HartnettMatt/AdvancedEmbeddedSoftware/README.md

# AdvancedEmbeddedSoftware
Matt's work in ECEN5713, Advanced Embedded Software
