HartnettMatt/AdvancedEmbeddedSoftware/final-project/hardware/3D_Printing/HBridge Mount.FCStd

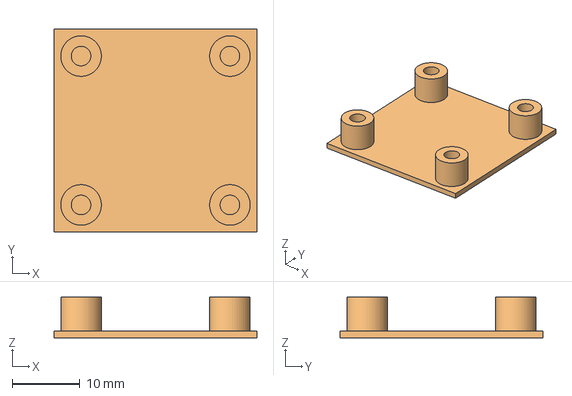
[picture p2: CAD file, 2025-11-16]
final-project/hardware/3D_Printing/HBridge Mount.FCStd
30.0 x 30.0 x 6.00 mm
H Bridge Mount001
H Bridge Mount
