HartnettMatt/AdvancedEmbeddedSoftware/final-project/hardware/3D_Printing/BottomPlatform.FCStd

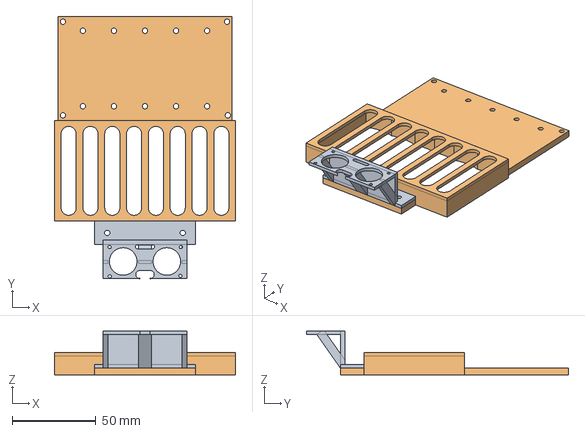
[picture p3: CAD file, 2025-11-16]
final-project/hardware/3D_Printing/BottomPlatform.FCStd
108.0 x 156.2 x 26.0 mm
Sensor Platform
Bottom Platform
