HartnettMatt/AdvancedEmbeddedSoftware/final-project/hardware/3D_Printing/9VBatteryHolder.FCStd

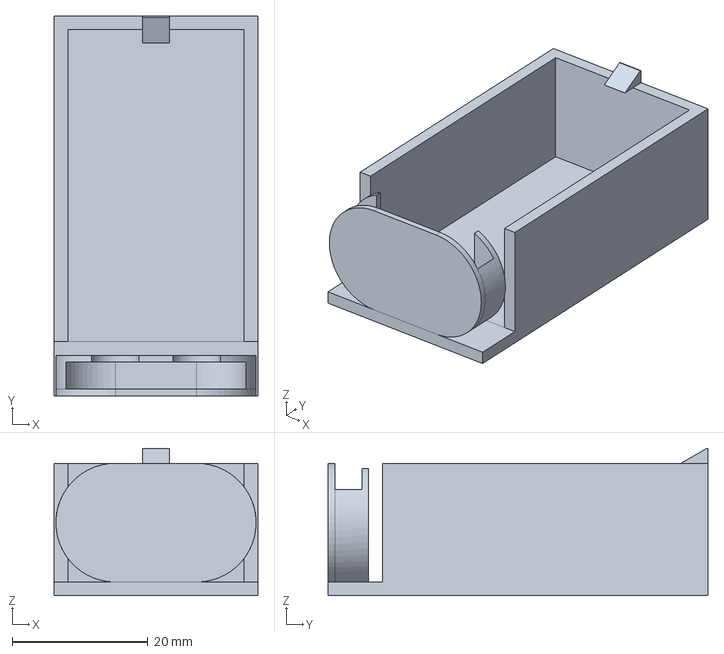
[picture p4: CAD file, 2025-11-16]
final-project/hardware/3D_Printing/9VBatteryHolder.FCStd
30.0 x 56.0 x 21.7 mm
