HartnettMatt/AdvancedEmbeddedSoftware/final-project/hardware/3D_Printing/PrimaryPlatform_v3.stl

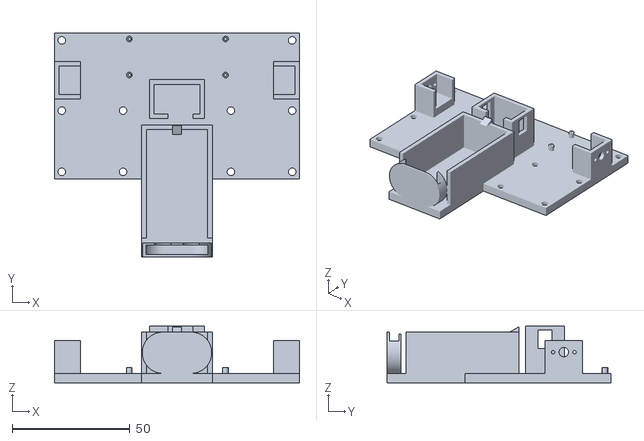
[picture p5: CAD file, 2025-11-16]
final-project/hardware/3D_Printing/PrimaryPlatform_v3.stl
104.0 x 95.0 x 24.0
