HartnettMatt/AdvancedEmbeddedSoftware/final-project/hardware/3D_Printing/WheelAdapter_v11.stl

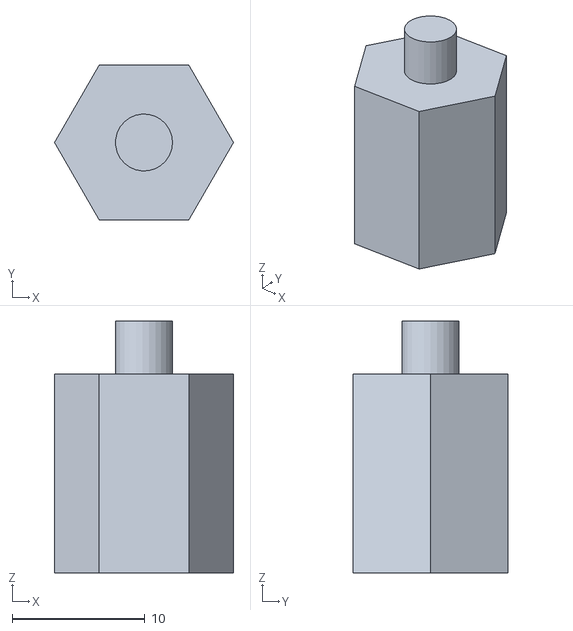
[picture p6: CAD file, 2025-11-16]
final-project/hardware/3D_Printing/WheelAdapter_v11.stl
13.5 x 11.7 x 19.0
