HartnettMatt/AdvancedEmbeddedSoftware/final-project/hardware/3D_Printing/Motor Platform.FCStd

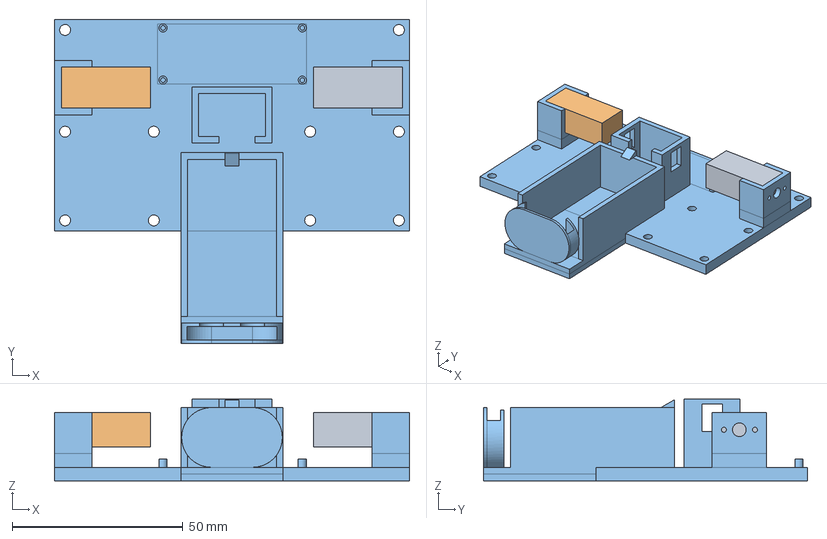
[picture p7: CAD file, 2025-11-16]
final-project/hardware/3D_Printing/Motor Platform.FCStd
104.0 x 95.0 x 24.0 mm
Motor001
Motor002
Primary Platform
