HartnettMatt/AdvancedEmbeddedSoftware/final-project/hardware/3D_Printing/Motor Mount.FCStd

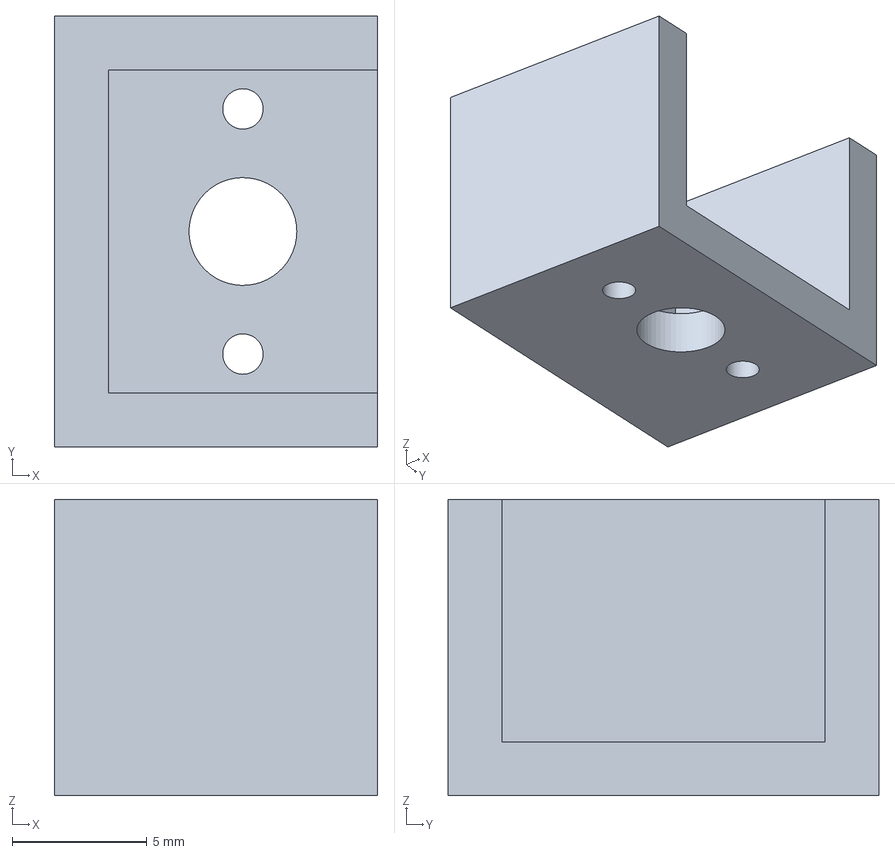
[picture p8: CAD file, 2025-11-16]
final-project/hardware/3D_Printing/Motor Mount.FCStd
12.0 x 16.0 x 11.0 mm
