HartnettMatt/AdvancedEmbeddedSoftware/final-project/hardware/3D_Printing/9VBatteryHolder_v3.stl

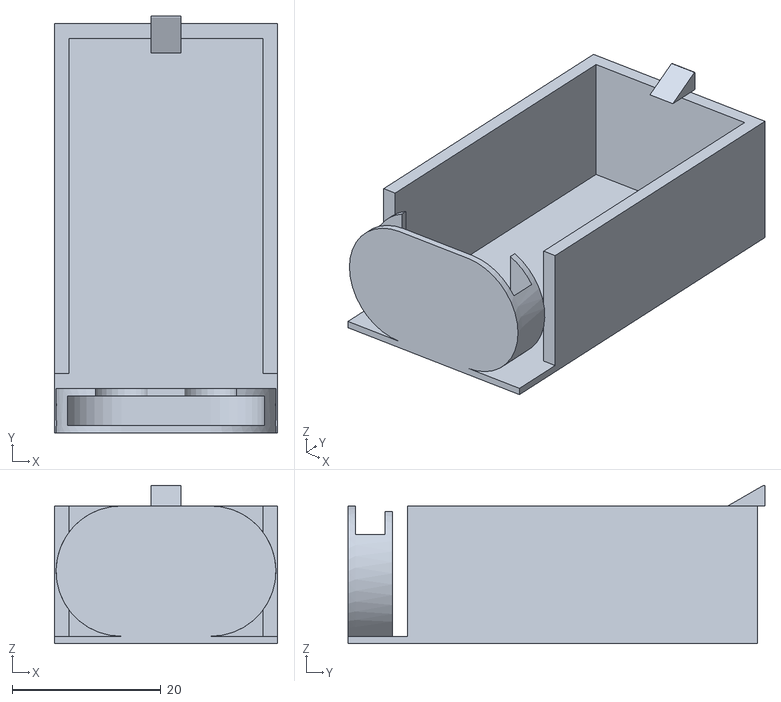
[picture p9: CAD file, 2025-05-31]
final-project/hardware/3D_Printing/9VBatteryHolder_v3.stl
30.0 x 56.0 x 21.3
