HartnettMatt/AdvancedEmbeddedSoftware/final-project/hardware/3D_Printing/MotorMount_v3.stl

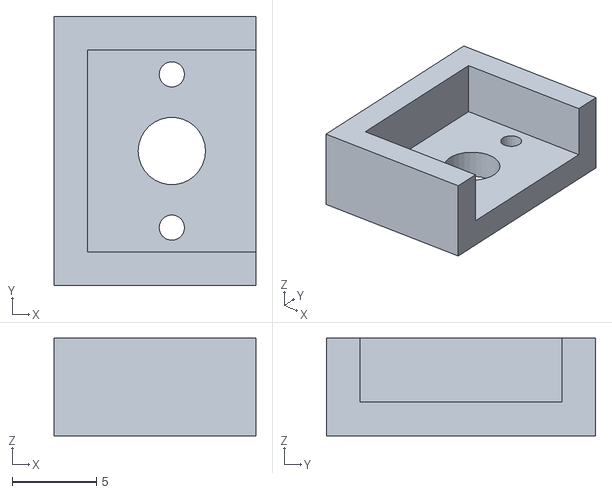
[picture p10: CAD file, 2025-05-31]
final-project/hardware/3D_Printing/MotorMount_v3.stl
12.0 x 16.0 x 5.80
