HartnettMatt/AdvancedEmbeddedSoftware/final-project/hardware/3D_Printing/Bottom Platform_v3.stl

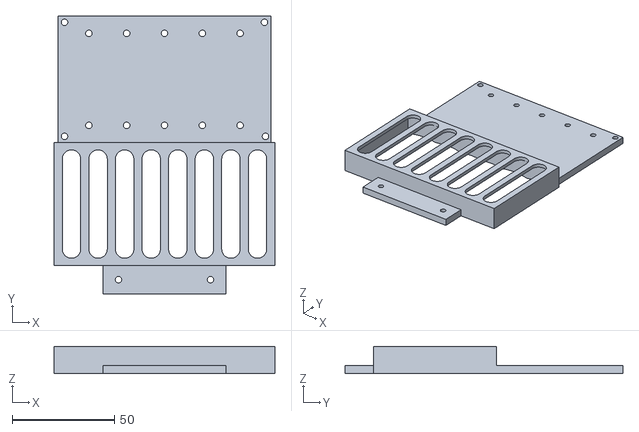
[picture p11: CAD file, 2025-05-31]
final-project/hardware/3D_Printing/Bottom Platform_v3.stl
108.0 x 136.0 x 13.3
