HartnettMatt/AdvancedEmbeddedSoftware/final-project/hardware/3D_Printing/Raspberry Pi Platform.FCStd

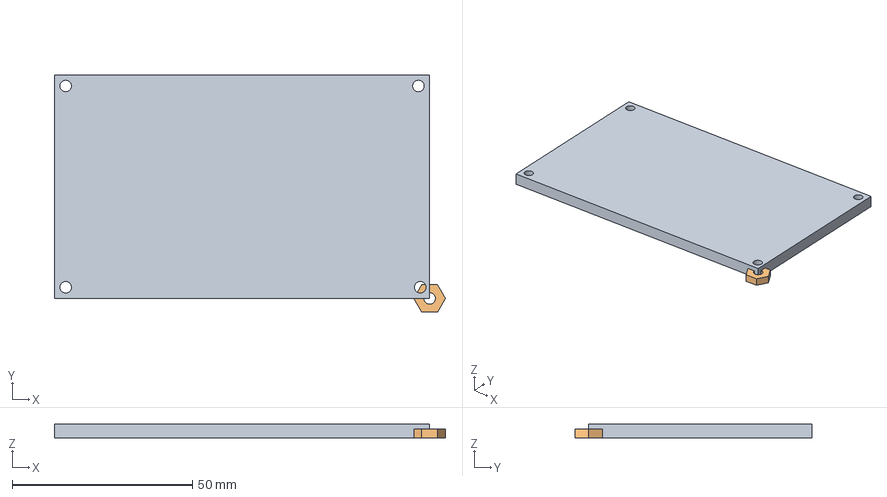
[picture p12: CAD file, 2025-05-23]
final-project/hardware/3D_Printing/Raspberry Pi Platform.FCStd
108.4 x 65.8 x 4.00 mm
Standard Platform
