HartnettMatt/AdvancedEmbeddedSoftware/final-project/hardware/3D_Printing/BottomPlatform-Sensor Platform.stl

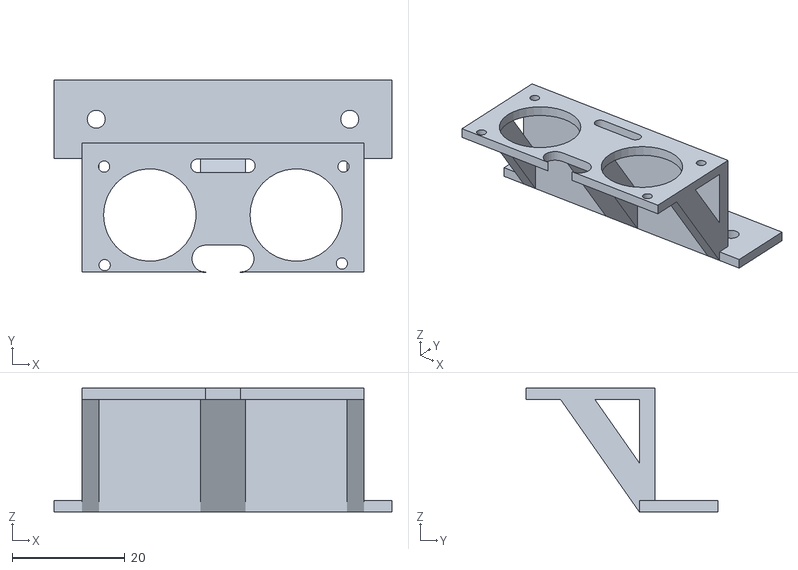
[picture p14: CAD file, 2025-05-23]
final-project/hardware/3D_Printing/BottomPlatform-Sensor Platform.stl
60.0 x 34.2 x 22.0
