HartnettMatt/AdvancedEmbeddedSoftware/final-project/hardware/3D_Printing/HCSR04_v1.stl

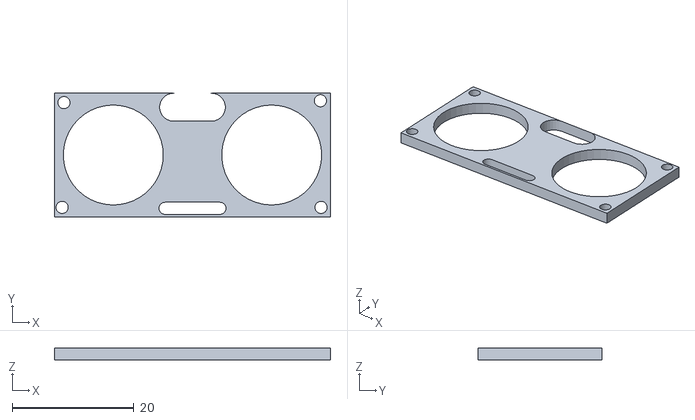
[picture p15: CAD file, 2025-04-28]
final-project/hardware/3D_Printing/HCSR04_v1.stl
45.3 x 20.3 x 2.00
