HartnettMatt/AdvancedEmbeddedSoftware/final-project/hardware/3D_Printing/EraserHolder_v1.stl

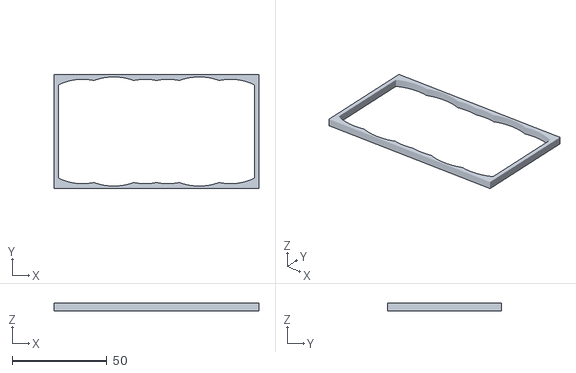
[picture p16: CAD file, 2025-04-25]
final-project/hardware/3D_Printing/EraserHolder_v1.stl
108.0 x 60.0 x 4.00
