HartnettMatt/AdvancedEmbeddedSoftware/final-project/hardware/3D_Printing/SwitchHolder_v3.stl

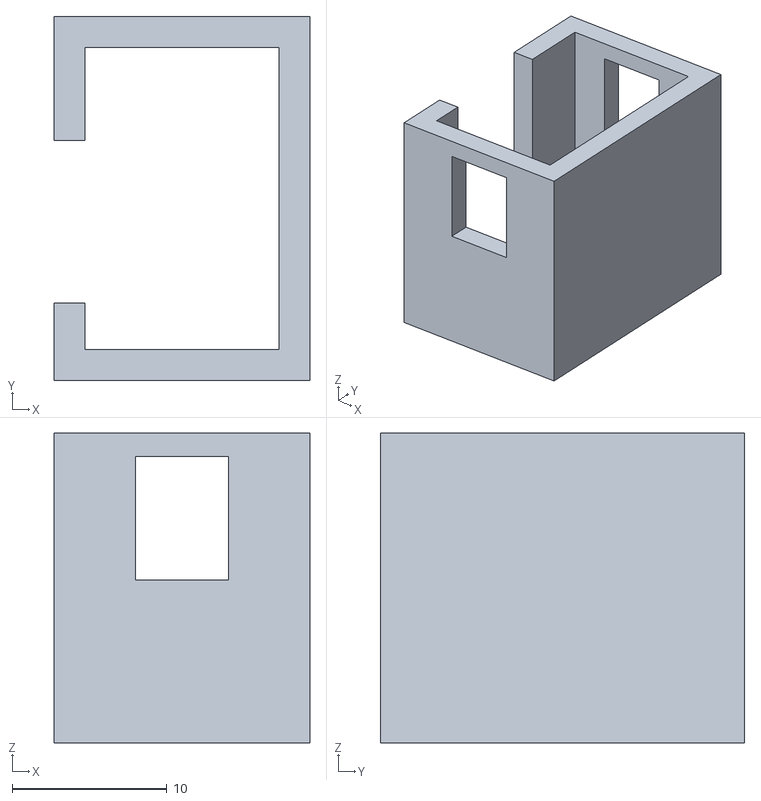
[picture p17: CAD file, 2025-04-19]
final-project/hardware/3D_Printing/SwitchHolder_v3.stl
16.5 x 23.5 x 20.0
