HartnettMatt/AdvancedEmbeddedSoftware/final-project/hardware/3D_Printing/BatteryPlatform_v1.stl

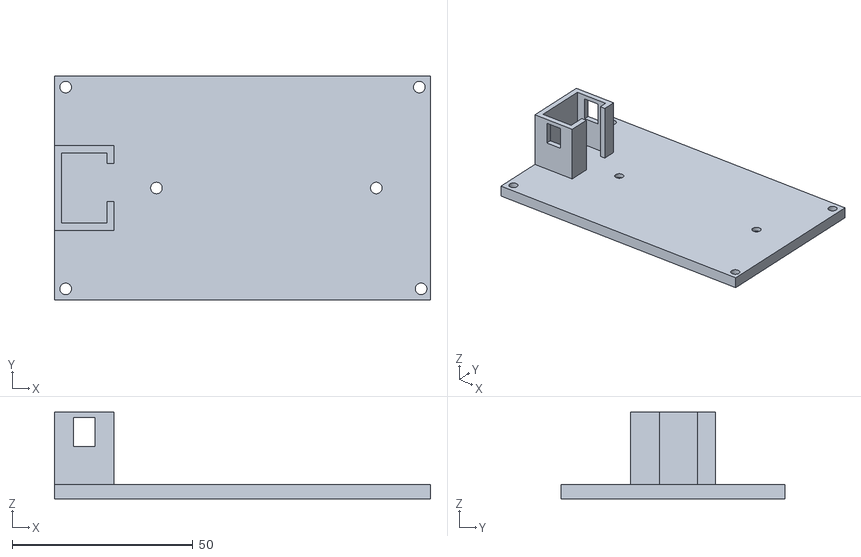
[picture p18: CAD file, 2025-04-19]
final-project/hardware/3D_Printing/BatteryPlatform_v1.stl
104.0 x 62.0 x 24.0
