HartnettMatt/AdvancedEmbeddedSoftware/final-project/hardware/3D_Printing/RaspberryPi Platform_v2.stl

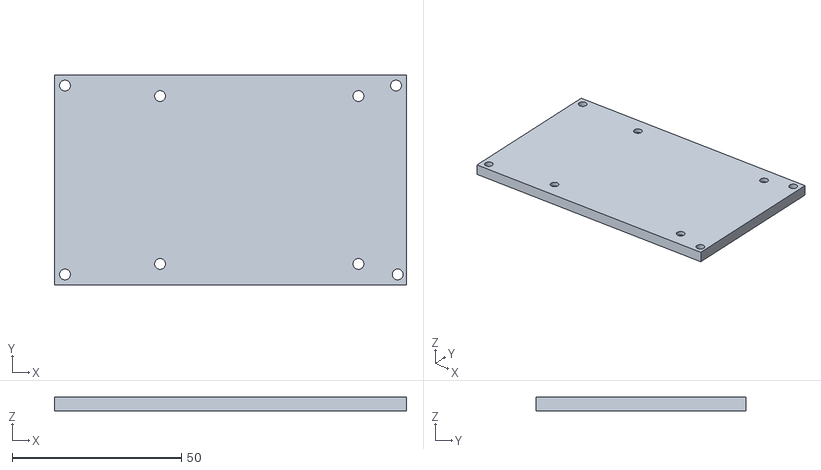
[picture p19: CAD file, 2025-04-18]
final-project/hardware/3D_Printing/RaspberryPi Platform_v2.stl
104.0 x 62.0 x 4.00
