HartnettMatt/AdvancedEmbeddedSoftware/final-project/hardware/3D_Printing/MotorMountPlatform_v1.stl

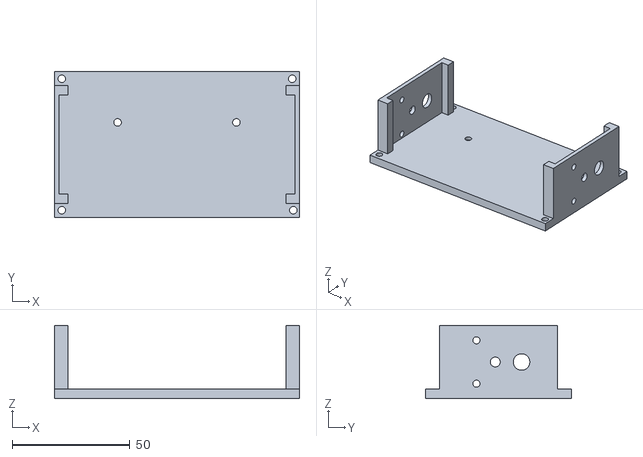
[picture p20: CAD file, 2025-04-13]
final-project/hardware/3D_Printing/MotorMountPlatform_v1.stl
104.0 x 62.0 x 31.0
