HartnettMatt/AdvancedEmbeddedSoftware/final-project/hardware/3D_Printing/Motor Mount-TestPrint.stl

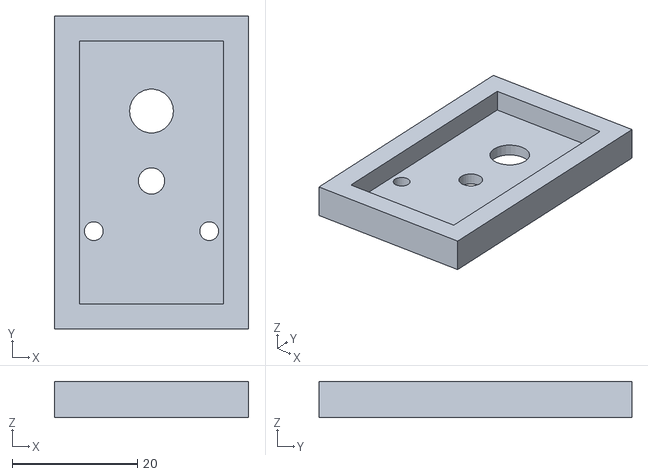
[picture p21: CAD file, 2025-04-08]
final-project/hardware/3D_Printing/Motor Mount-TestPrint.stl
31.0 x 49.9 x 5.80
