HartnettMatt/AdvancedEmbeddedSoftware/(list of files, cad)

Other CAD files:
final-project/hardware/3D_Printing/WheelAdapter.FCStd
final-project/hardware/3D_Printing/Primary Platform.FCStd
final-project/hardware/3D_Printing/Eraser Platform.FCStd
final-project/hardware/3D_Printing/Battery Platform.FCStd
final-project/hardware/3D_Printing/9VBatteryHolder_v1.stl
final-project/hardware/3D_Printing/9VBatteryHolder_v2.stl
final-project/hardware/3D_Printing/Bottom Platform_v1.stl
final-project/hardware/3D_Printing/Bottom Platform_v2.stl
final-project/hardware/3D_Printing/HBridgeMount.FCStd
final-project/hardware/3D_Printing/HBridgeMount.stl
final-project/hardware/3D_Printing/MotorMount_v2.stl
final-project/hardware/3D_Printing/PrimaryPlatform_v1.stl
final-project/hardware/3D_Printing/PrimaryPlatform_v2.stl
final-project/hardware/3D_Printing/RaspberryPi Platform.FCStd
final-project/hardware/3D_Printing/RaspberryPi Platform_v1.stl
final-project/hardware/3D_Printing/SwitchHolder_v1.stl
final-project/hardware/3D_Printing/SwitchHolder_v2.stl
final-project/hardware/3D_Printing/WheelAdapter_v1.stl
final-project/hardware/3D_Printing/WheelAdapter_v10.stl
final-project/hardware/3D_Printing/WheelAdapter_v2.stl
final-project/hardware/3D_Printing/WheelAdapter_v3.stl
final-project/hardware/3D_Printing/WheelAdapter_v4.stl
final-project/hardware/3D_Printing/WheelAdapter_v5.stl
final-project/hardware/3D_Printing/WheelAdapter_v6.stl
final-project/hardware/3D_Printing/WheelAdapter_v7.stl
final-project/hardware/3D_Printing/WheelAdapter_v8.stl
final-project/hardware/3D_Printing/WheelAdapter_v9.stl
