HartnettMatt/AdvancedEmbeddedSoftware/(threads)

Thread 1 (2025-04-05):

Sprint 1

HartnettMatt, 2025-04-05:
**Goal:** Get the Pi Zero W running a Buildroot image and verify motor movement.

### Tasks:
- [x] Set up Buildroot for Raspberry Pi 3 Model B
- [x] Enable SSH and GPIO in the image
- [x] Test basic GPIO output (LED or print statements)
- [x] Wire up motor driver and one motor
- [x] Write minimal motor control app (forward, backward, stop)
- [x] Push code and image to GitHub

### Deliverables:
- Pi boots into custom Buildroot image
- Motors move under software control
- Code and config version-controlled

HartnettMatt, 2025-04-13:
Switched from Raspberry Pi Zero W to Raspberry Pi 3 Model B due to hardware issues with Zero W

HartnettMatt, 2025-04-14:
Successfully finished sprint 1!
https://github.com/HartnettMatt/AdvancedEmbeddedSoftware/commit/6cdb0e69be6b10a1c346a62349fb4fb5f5f6e64c
https://github.com/cu-ecen-aeld/final-project-HartnettMatt/commit/a8c93982284dfb1a385d652fd471db8d85029d3e

Closed 2025-04-14.

Thread 2 (2025-04-08):

Hardware

HartnettMatt, 2025-04-08:
**Goal:** Design an effective hardware platform for the robot.

### Tasks:
- [x] Design Chassis
- [x] 3D Print Chassis
- [x] Install Hardware on Chassis
- [x] Design H-Bridge and Sensor Circuits
- [x] Implement circuit design
- [x] Validate motor control with Raspberry Pi
- [ ] Assemble
**Stretch Goals:**
- [ ] Design and order custom PCB

### Deliverables:
- Fully functional hardware platform

HartnettMatt, 2025-04-28:
Did not complete the stretch goal of a custom PCB, and I had some trouble with my final print, but most hardware is complete.

Closed 2025-04-28.

Thread 3 (2025-04-08):

Chassis/3D Printing

HartnettMatt, 2025-04-08:
**Goal:** 3D Print Chassis

### Tasks:
- [x] Motor mount design
- [x] Motor mount test print
- [x] Sensor mount design
- [x] Sensor mount test print
- [x] Wheel design
- [x] Wheel test print
- [x] Magnet mount design
- [x] Magnet mount test print
- [x] Whiteboard eraser mount design
- [x] Whiteboard eraser mount test print
- [x] Full chassis design
- [x] Full chassis print

### Deliverables:
- Fully printed chassis

HartnettMatt, 2025-04-28:
Final design here:
https://github.com/HartnettMatt/AdvancedEmbeddedSoftware/commit/d585ecf899477b4db2ee4ed111087b619c2c1750

Closed 2025-04-28.

Thread 4 (2025-04-08):

Part Procurement

HartnettMatt, 2025-04-08:
### List of parts to purchase

- [x] Distance sensor
- [x] Whiteboard eraser
- [x] Tires

HartnettMatt, 2025-04-13:
Parts purchased, ETA 4/14/2025

Closed 2025-04-13.

Thread 5 (2025-04-08):

Electrical

HartnettMatt, 2025-04-08:
** Goal: ** Fully design and implement control electronics for motors and sensors

### Tasks:
 - [x] Design H-bridge circuit
 - [x] Simulate H-bridge circuit
 - [x] Implement and test H-bridge circuit
 - [x] Design distance sensor circuit
 - [x] Simulate distance sensor circuit
 - [x] Implement and test sensor circuit
 - [x] Integrate all circuits together, with raspberry pi zero

### Deliverables:
- H-bridge and distance sensor electronics

HartnettMatt, 2025-04-25:
All electrical systems are designed, implemented and tested!

Closed 2025-04-25.

Thread 6 (2025-04-12):

Sprint 2

HartnettMatt, 2025-04-12:
**Goal:** Add and test distance sensors to detect the whiteboard edge.

### Tasks:
- [x] Integrate ultrasonic sensor via GPIO/I2C
- [x] Test sensor distance readings
- [x] Write safety logic to stop motors near edges
- [x] Combine motor control + edge detection into main loop
- [x] Begin building robot chassis and mounting sensors

### Deliverables:
- Sensor values printed/logged in real-time
- Robot can detect an edge and stop motors
- Physical structure of robot is mostly complete

HartnettMatt, 2025-04-19:
Finished sprint 2! Robot is mostly assembled, still need to mount the sensor and solder it up, but the main control software is functional, although it is difficult to test since the robot is not independent due to the lack of sensor mounting.
https://github.com/cu-ecen-aeld/final-project-HartnettMatt/commit/5795afed059cc70221098619aa1118ff8a271734
https://github.com/HartnettMatt/AdvancedEmbeddedSoftware/commit/6facc6b1fe7785573f8cb9db413c5d62dd23aaa8

Closed 2025-04-19.

Thread 7 (2025-04-12):

Sprint 3

HartnettMatt, 2025-04-12:
### Tasks:
- [x] Write a simple cleaning pattern (zig-zag, spiral, random)
- [x] Finalize physical robot frame with magnets and eraser
- [x] Add optional remote start (e.g., button, MQTT, or SSH)
- [ ] Record video of wipe cycle
- [x] Polish code, comment, and README for final turn-in

### Deliverables:
- Robot moves safely and wipes at least part of a board
- Final repo includes working code, build instructions
- Video or demo run available

HartnettMatt, 2025-04-25:
Added auto-start so all that is required is powering on:
https://github.com/cu-ecen-aeld/final-project-HartnettMatt/commit/2de2eb58fe3a221e39437246b41e6ee95bf93979

HartnettMatt, 2025-04-28:
Here is my polished code push, along with the final hardware design. Unfortunately I was unable to record a video at this time, as I've had too many issues with my 3D printer to finish assembly at the moment.
https://github.com/HartnettMatt/AdvancedEmbeddedSoftware/commit/d585ecf899477b4db2ee4ed111087b619c2c1750

Closed 2025-04-28.
