HartnettMatt/AdvancedEmbeddedSoftware/final-project/hardware/Spice/HBrdige.asc

L1: ind; 2.2mH
M1: nmos; RTR040N03
M2: nmos; RTR040N03
M3: pmos; RRR040P03
M4: pmos; RRR040P03
R1: res; 2.1
V1: voltage; 9
V2: voltage; PULSE(0 3.3 0 1ns 1ns 10ms 0.1 10)
V3: voltage; PULSE(0 3.3 0.05 1ns 1ns 10ms 0.1 10)
Named nets: 0
.tran 1s
Motor +
Motor -
