HartnettMatt/AdvancedEmbeddedSoftware/final-project/hardware/PCB/HBridge.kicad_pcb

## KiCad design final-project/hardware/PCB/HBridge.kicad_pcb (2025-05-30)

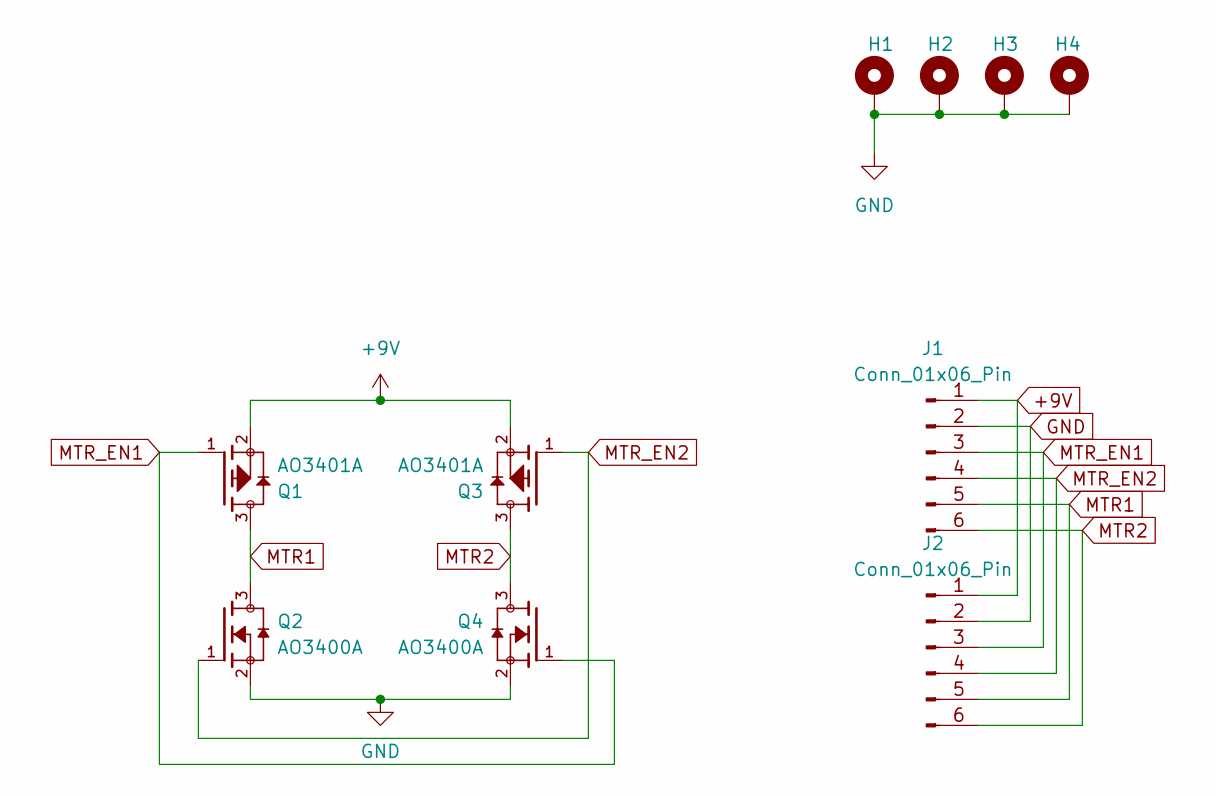
[picture p22: schematic HBridge.kicad_sch]

Parts:
H1, H2, H3, H4: MountingHole_Pad; MountingHole_3.2mm_M3_DIN965_Pad
J1, J2: Conn_01x06_Pin; PinHeader_1x06_P2.54mm_Vertical
Q1, Q3: AO3401A; PARTREV L
Q2, Q4: AO3400A; SOT95P280X125-3N; PARTREV L

Connections:
+9V: J1.1, J2.1, Q1.2, Q3.2
GND: H1.1, H2.1, H3.1, H4.1, J1.2, J2.2, Q2.2, Q4.2
MTR1: J1.5, J2.5, Q1.3, Q2.3
MTR2: J1.6, J2.6, Q3.3, Q4.3
MTR_EN1: J1.3, J2.3, Q1.1, Q4.1
MTR_EN2: J1.4, J2.4, Q2.1, Q3.1

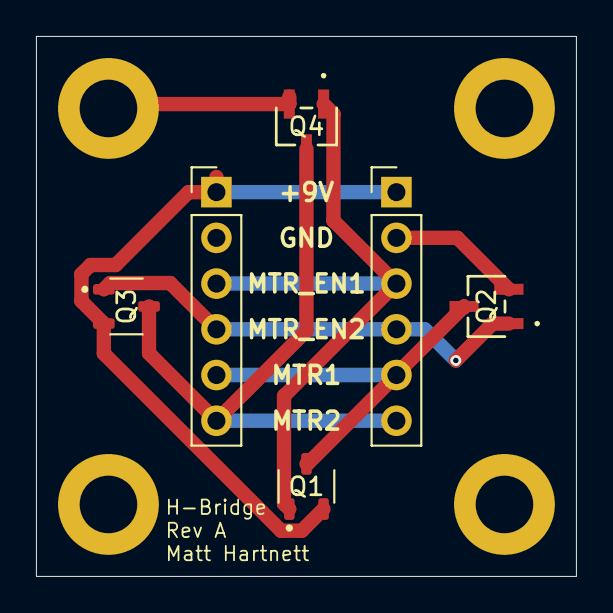
[picture p23: board HBridge.kicad_pcb from above]

Board: 2 copper layers, 30.0 x 30.0 mm, 10 parts (0 on the bottom side), 6 nets.
