HartnettMatt/AdvancedEmbeddedSoftware/final-project/driver/whiteboard_wiper/whiteboard_wiper.h

#ifndef WHITEBOARD_WIPER_H
#define WHITEBOARD_WIPER_H


#include <errno.h>
#include <stdio.h>
#include <stdlib.h>
#include <string.h>
#include "inc/gpiod.h"
#include "inc/motor.h"
#include "inc/hcsr04.h"

#define CAL_CYCLES 10
#define WALL_RANGE 0.05
#define TURNAROUND_TIME 1000000
#define REVERSE_TIME 1000000


#endif // WHITEBOARD_WIPER_H
