HartnettMatt/AdvancedEmbeddedSoftware/final-project/driver/whiteboard_wiper/inc/gpiod.c

/**
 * @file gpiod.c
 * @brief GPIO line request implementations for input and output.
 * @details
 * This file provides two functions to request GPIO lines from a GPIO chip
 * for use as either outputs (with an initial value) or inputs.  The code
 * has been adapted from the libgpiod repository:
 * https://git.kernel.org/pub/scm/libs/libgpiod/libgpiod.git/tree/examples
 *
 */

#include "gpiod.h"

struct gpiod_line_request *
request_output_line(const char *chip_path, unsigned int offset,
                    enum gpiod_line_value value, const char *consumer) {
    struct gpiod_request_config *req_cfg = NULL;
    struct gpiod_line_request *request = NULL;
    struct gpiod_line_settings *settings;
    struct gpiod_line_config *line_cfg;
    struct gpiod_chip *chip;
    int ret;

    chip = gpiod_chip_open(chip_path);
    if (!chip)
        return NULL;

    settings = gpiod_line_settings_new();
    if (!settings)
        goto close_chip;

    gpiod_line_settings_set_direction(settings, GPIOD_LINE_DIRECTION_OUTPUT);
    gpiod_line_settings_set_output_value(settings, value);

    line_cfg = gpiod_line_config_new();
    if (!line_cfg)
        goto free_settings;

    ret = gpiod_line_config_add_line_settings(line_cfg, &offset, 1, settings);
    if (ret)
        goto free_line_config;

    if (consumer) {
        req_cfg = gpiod_request_config_new();
        if (!req_cfg)
            goto free_line_config;
        gpiod_request_config_set_consumer(req_cfg, consumer);
    }

    request = gpiod_chip_request_lines(chip, req_cfg, line_cfg);
    gpiod_request_config_free(req_cfg);

free_line_config:
    gpiod_line_config_free(line_cfg);

free_settings:
    gpiod_line_settings_free(settings);

close_chip:
    gpiod_chip_close(chip);

    return request;
}

struct gpiod_line_request *
request_input_line(const char *chip_path, unsigned int offset,
                   const char *consumer) {
    struct gpiod_request_config *req_cfg = NULL;
    struct gpiod_line_request *request = NULL;
    struct gpiod_line_settings *settings;
    struct gpiod_line_config *line_cfg;
    struct gpiod_chip *chip;
    int ret;

    chip = gpiod_chip_open(chip_path);
    if (!chip)
        return NULL;

    settings = gpiod_line_settings_new();
    if (!settings)
        goto close_chip;

    gpiod_line_settings_set_direction(settings, GPIOD_LINE_DIRECTION_INPUT);

    line_cfg = gpiod_line_config_new();
    if (!line_cfg)
        goto free_settings;

    ret = gpiod_line_config_add_line_settings(line_cfg, &offset, 1, settings);
    if (ret)
        goto free_line_config;

    if (consumer) {
        req_cfg = gpiod_request_config_new();
        if (!req_cfg)
            goto free_line_config;
        gpiod_request_config_set_consumer(req_cfg, consumer);
    }

    request = gpiod_chip_request_lines(chip, req_cfg, line_cfg);
    gpiod_request_config_free(req_cfg);

free_line_config:
    gpiod_line_config_free(line_cfg);

free_settings:
    gpiod_line_settings_free(settings);

close_chip:
    gpiod_chip_close(chip);

    return request;
}
