HartnettMatt/AdvancedEmbeddedSoftware/(commit log)

2025-04-08 Rev 1 of the motor mount
    [Motor Mount-TestPrint.stl, Motor Mount.FCStd]
2025-04-08 Added gitignore, finished rev 2 of motor mount
    [Motor Mount-TestPrint.stl, Motor Mount.FCStd]
2025-04-13 First attempt at GPIO test driver
2025-04-13 Updated H Bridge circuit sim
2025-04-13 Switched from - to _ in gpio_test file and folder names
2025-04-13 Reverted back to LIBGPIOD
    [gpio_test.c]
2025-04-13 Designed and printed v1 of the motor mount platform
    [Motor Mount.FCStd, Motor Platform.FCStd, MotorMountPlatform_v1.stl]
2025-04-14 Changed from single GPIO toggle to full motor power on self test
2025-04-17 Added hardware docs and designed v1 of Raspberry Pi Platform
    [RaspberryPi Platform.FCStd, RaspberryPi Platform_v1.stl]
2025-04-17 Designed wheel adapter version 1
    [WheelAdapter.FCStd, WheelAdapter_v1.stl]
2025-04-17 Renamed driver README and wrote a hcsr04 port and test
2025-04-18 Redesigned RPi platform and wheel adapter
    [RaspberryPi Platform.FCStd, RaspberryPi Platform_v2.stl, WheelAdapter.FCStd, WheelAdapter_v2.stl, WheelAdapter_v3.stl, WheelAdapter_v4.stl]
2025-04-18 Fixed bugs in port code
    [hcsr04_port.c]
2025-04-18 Switched to event driven instead of polling
    [Battery Platform.FCStd, SwitchHolder_v1.stl]
2025-04-18 Hopefully fixed post init stuck issue
    [hcsr04_port.c, hcsr04_test.c]
2025-04-18 Clamped values to be less than 1000us
2025-04-19 Fixed more more issues
    [whiteboard_wiper.c]
2025-04-19 Designed v1 of the battery holder
    [Battery Platform.FCStd, BatteryPlatform_v1.stl, SwitchHolder_v2.stl, SwitchHolder_v3.stl]
2025-04-19 Added more prints
2025-04-19 Fixed dumb bug in motor
    [motor.c, whiteboard_wiper.c]
2025-04-19 Missed save of platform
    [RaspberryPi Platform.FCStd]
2025-04-25 Designed v1 of the eraser holder
    [Eraser Platform.FCStd, EraserHolder_v1.stl]
2025-04-28 Finished designing all prints, updated README
    [Bottom Platform_v1.stl, BottomPlatform.FCStd, Eraser Platform.FCStd, HCSR04_v1.stl]
2025-05-23 Updated bottom platform and finished iteration 1 of hardware system
    [Bottom Platform_v2.stl, BottomPlatform-Front Mount_v1.stl, BottomPlatform-Sensor Platform.stl, BottomPlatform.FCStd, Motor Platform.FCStd, Raspberry Pi Platform.FCStd]
2025-05-23 Started a new wheel adapter for newer, smaller motors
    [WheelAdapter.FCStd, WheelAdapter_v5.stl]
2025-05-26 Finished making new wheel adapter that fits with new motors
    [WheelAdapter.FCStd, WheelAdapter_v10.stl, WheelAdapter_v6.stl, WheelAdapter_v7.stl, WheelAdapter_v8.stl, WheelAdapter_v9.stl]
2025-05-30 Finished H Bridge PCB design
    [HBridge-B_Cu.gbr, HBridge-B_Mask.gbr, HBridge-B_Paste.gbr, HBridge-B_Silkscreen.gbr, HBridge-Edge_Cuts.gbr, HBridge-F_Cu.gbr, HBridge-F_Mask.gbr, HBridge-F_Paste.gbr]
2025-05-31 Made a lot of progress on the new main body of the updated robot
    [9VBatteryHolder.FCStd, 9VBatteryHolder_v1.stl, 9VBatteryHolder_v2.stl, Bottom Platform_v3.stl, BottomPlatform.FCStd, Motor Mount.FCStd, Motor Platform.FCStd, MotorMount_v2.stl]
2025-05-31 PCB Backup update
2025-05-31 Battery Holder V3
    [9VBatteryHolder.FCStd, 9VBatteryHolder_v3.stl]
2025-11-16 Continued work on whiteboard robot
    [9VBatteryHolder.FCStd, BottomPlatform.FCStd, HBridge Mount.FCStd, HBridgeMount.FCStd, HBridgeMount.stl, Motor Mount.FCStd, Motor Platform.FCStd, Primary Platform.FCStd]
